lnsru/melexis_VGA_ToF_camera/impedance.png

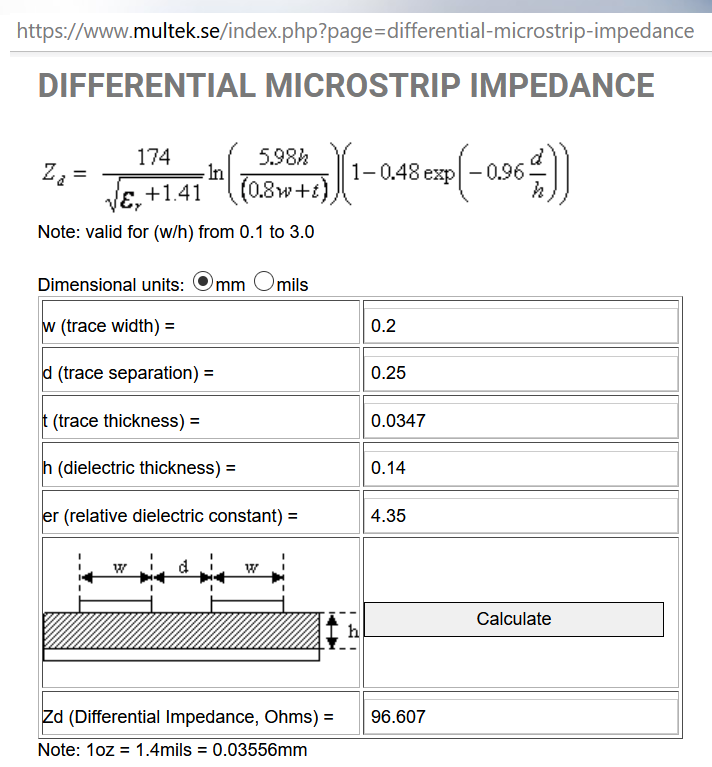
impedance.png
