lnsru/melexis_VGA_ToF_camera/BOM_v2/ToF_camera_VGA.xlsx

Reference | Quantity |  | Value | Footprint | Datasheet | Description | Height | Manufacturer_Name | Manufacturer_Part_Number | Mouser Part Number | Mouser Price/Stock
C10 | 1 |  | 430p | Capacitor_SMD:C_0805_2012Metric | ~
C22 C25 C20 C23 C26 C11 C12 C32 C33 | 9 |  | 100n | Capacitor_SMD:C_0805_2012Metric | ~
C5 C17 C15 C14 C1 C16 C3 C28 | 8 |  | 1u | Capacitor_SMD:C_0805_2012Metric | ~
C7 C6 C4 C2 | 4 | 50 | 4.7u | Capacitor_SMD:C_0805_2012Metric | ~
C9 C13 C18 C21 C19 C8 C31 C29 | 8 |  | 10u | Capacitor_SMD:C_0805_2012Metric | ~
CP27 | 1 |  | 68u | Capacitor_Tantalum_SMD:CP_EIA-7343-30_AVX-N | ~
D1 | 1 |  | LED | LED_SMD:LED_1206_3216Metric | ~
H1 H2 | 2 |  | MountingHole | myFootprints:MountingHole_1.5mm | ~
J1 | 1 | 6 | 54548-2271_connector_RPi_zero | myFootprints:545482271_RPi_Zero_connector | http://www.molex.com/webdocs/datasheets/pdf/en-us//0545482271_FFC_FPC_CONNECTORS.pdf | FFC & FPC Connectors 0.5 FPC ZIF Hsg Assy ssy 22Ckt EmbsTp Pkg | 1 | Molex | 54548-2271 | 538-54548-2271 | https://www.mouser.co.uk/ProductDetail/Molex/54548-2271?qs=qM7ngqbhX5X3ZiWzRWv9wA%3D%3D
J13 J11 J15 | 3 |  | Conn_01x01 | TestPoint:TestPoint_Pad_1.0x1.0mm | ~
J16 J10 J14 J12 | 4 |  | Conn_01x01 | TestPoint:TestPoint_Pad_2.0x2.0mm | ~
J17 J18 | 2 |  | Conn_01x01 | TestPoint:TestPoint_Pad_4.0x4.0mm | ~
J2 | 1 |  | Conn_01x01 | Connector_PinHeader_2.54mm:PinHeader_1x01_P2.54mm_Vertical | ~
J3 | 1 |  | Conn_01x04 | Connector_PinHeader_2.54mm:PinHeader_1x04_P2.54mm_Vertical | ~
J4 | 1 |  | Conn_01x01 | TestPoint:TestPoint_Pad_D1.5mm | ~
J5 J6 | 2 |  | Conn_01x04 | Connector_PinHeader_2.54mm:PinHeader_2x02_P2.54mm_Vertical | ~
J7 | 1 |  | Conn_01x02 | Resistor_SMD:R_0603_1608Metric | ~
J9 | 1 |  | Conn_01x03 | Jumper:SolderJumper-3_P1.3mm_Bridged2Bar12_RoundedPad1.0x1.5mm | ~
L1 | 1 |  | L | Inductor_SMD:L_1210_3225Metric | ~
MK1 MK2 MK3 MK4 | 4 |  | Mounting_Hole_PAD | MountingHole:MountingHole_3.2mm_M3
R17 | 1 | 50 | 10k | Resistor_SMD:R_0805_2012Metric | ~
R2 R1 | 2 |  | 1k5 | Resistor_SMD:R_0805_2012Metric | ~
R3 | 1 |  | 200k | Resistor_SMD:R_0805_2012Metric | ~
R6 | 1 |  | 100k | Resistor_SMD:R_0805_2012Metric | ~
R7 | 1 |  | 49.9k | Resistor_SMD:R_0805_2012Metric | ~
SW1 | 1 |  | SW_Push | Button_Switch_SMD:SW_SPST_EVPBF | ~
U1 | 1 |  | LP5907MFX-1.8 | Package_TO_SOT_SMD:SOT-23-5 | http://www.ti.com/lit/ds/symlink/lp5907.pdf
U2 | 1 |  | MLX75027 | myFootprints:MLX75027_NSMD
U3 | 1 |  | LP5907MFX-1.2 | Package_TO_SOT_SMD:SOT-23-5 | http://www.ti.com/lit/ds/symlink/lp5907.pdf
U4 | 1 |  | LP5907MFX-2.8 | Package_TO_SOT_SMD:SOT-23-5 | http://www.ti.com/lit/ds/symlink/lp5907.pdf
U5 | 1 | 5 | PCA9306 | Package_SO:SSOP-8_2.95x2.8mm_P0.65mm | http://www.ti.com/lit/ds/symlink/pca9306.pdf
U6 | 1 |  | TPS82130 | Package_LGA:Texas_SIL0008D_MicroSiP-8-1EP_2.8x3mm_P0.65mm_EP1.1x1.9mm_ThermalVias | http://www.ti.com/lit/ds/symlink/tps82130.pdf
Y1 | 1 |  | DSC6011JI1A-008.0000_clock_source | myFootprints:DSC6011JI1A0080000_clock_source | https://componentsearchengine.com/Datasheets/1/DSC6011JI1A-008.0000.pdf | Standard Clock Oscillators MEMS Oscillator Ultr a Low PWR LVCMOS - | 0.89 | Microchip | DSC6011JI1A-008.0000 | 579-011JI1A0080000 | https://www.mouser.co.uk/ProductDetail/Microchip-Technology/DSC6011JI1A-0080000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
 |  |  | Solder flux | CQ4LF (https://www.mouser.de/ProductDetail/Chip-Quik/CQ4LF?qs=1mbolxNpo8eyk0SwJVaLbQ%3D%3D)
 |  |  | Solder paste | TS391AX50 | http://www.chipquik.com/datasheets/TS391AX50.pdf
