lnsru/melexis_VGA_ToF_camera/ToF_camera_VGA.ods

Sheet: ToF_camera_VGA
Reference | Quantity | Value | Footprint | Datasheet
C10 C14 C3 | 3 | 430p, 1m | Capacitors_SMD:C_0805 | ~
C1 C8 C9 C11 C12 C13 C15 C17 C18 C19 | 10 | 22u | Capacitors_SMD:C_0805 | ~
C16 | 1 | 220u | Capacitors_SMD:CP_Elec_4x5.8 | https://eu.mouser.com/ProductDetail/Lelon/VZT221M0JTR-0506 | VZT221M0JTR-0506
C5 | 1 | 1u | Capacitors_SMD:C_0805 | ~
C7 C6 C4 C2 | 4 | 4.7u | Capacitors_SMD:C_0805 | ~
J1 | 1 | Conn_01x22 | myFootprints:FPC_22 | https://eu.mouser.com/ProductDetail/Molex/54548-2271 | 54548-2271
J3 J5 J6 | 3 | Conn_01x04 | Pin_Headers:Pin_Header_Straight_1x04_Pitch2.54mm | ~
J4 J2 | 2 | Conn_01x01 | Pin_Headers:Pin_Header_Straight_1x01_Pitch2.54mm | ~
J8 | 1 | Conn_01x02 | Resistors_SMD:R_0201_NoSilk | ~
JP1 | 1 | SolderJumper_3_Open | Pin_Headers:Pin_Header_Straight_1x03_Pitch1.00mm_SMD_Pin1Right | ~
L1 | 1 | L | Inductors:Inductor_1212 | ~
MK1 MK2 MK3 MK4 | 4 | Mounting_Hole_PAD | Mounting_Holes:MountingHole_2.7mm
R12 | 1 | 124k | Resistors_SMD:R_0805 | ~
R14 | 1 | 4.12k | Resistors_SMD:R_0805 | ~
R15 | 1 | 110k | Resistors_SMD:R_0805 | ~
R16 | 1 | 200k | Resistors_SMD:R_0805 | ~
R2 R1 R10 R11 R17 | 5 | 10k | Resistors_SMD:R_0805 | ~
R4 | 1 | 237k | Resistors_SMD:R_0805 | ~
R6 R9 R3 | 3 | 100k | Resistors_SMD:R_0805 | ~
R7 | 1 | 49.9k | Resistors_SMD:R_0805 | ~
R8 R13 R5 | 3 | 100k | Resistors_SMD:R_0402 | ~
SW1 | 1 | SW_Push | Buttons_Switches_SMD:SW_SPST_EVPBF | https://eu.mouser.com/ProductDetail/Panasonic/EVP-BFAC1A000 | EVP-BFAC1A000
U2 | 1 | MLX75027 | myFootprints:MLX75027 | https://eu.mouser.com/ProductDetail/Melexis/MLX75027RTC-ABA-200-TR | MLX75027RTC-ABA-200-TR
U3 U4 U1 | 3 | TPS82150 | myFootprints:TPS82130 | https://eu.mouser.com/ProductDetail/Texas-Instruments/TPS82150SILR |  | http://www.ti.com/lit/ds/symlink/tps82150.pdf
U5 | 1 | TPSM84624 | myFootprints:TPSM84624 | https://eu.mouser.com/ProductDetail/Texas-Instruments/TPSM84624MOLR
U6 | 1 | PCA9306 | Housings_SSOP:SSOP-8_2.95x2.8mm_Pitch0.65mm | https://eu.mouser.com/ProductDetail/Texas-Instruments/PCA9306DCTR | PCA9306DCTR | http://www.ti.com/lit/ds/symlink/pca9306.pdf
Y1 | 1 | Crystal | Crystals: 5 mm x 3.2 mm | https://eu.mouser.com/ProductDetail/ECS/ECS-80-12-30Q-DS-TR
 |  |  |  | https://eu.mouser.com/ProductDetail/TXC-Corporation/7A-8000MAAJ-T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

Sheet: ToF_camera_bw
Reference | Quantity | Value | Footprint | Datasheet
C10 C14 C3 | 3 | 430p, 1m | Capacitors_SMD:C_0805 | ~
C1 C8 C9 C11 C12 C13 C15 C17 C18 C19 | 10 | 22u | Capacitors_SMD:C_0805 | ~
C16 | 1 | 220u | Capacitors_SMD:CP_Elec_4x5.8 | https://eu.mouser.com/ProductDetail/Lelon/VZT221M0JTR-0506 | VZT221M0JTR-0506
C5 | 1 | 1u | Capacitors_SMD:C_0805 | ~
C7 C6 C4 C2 | 4 | 4.7u | Capacitors_SMD:C_0805 | ~
J1 | 1 | Conn_01x22 | myFootprints:FPC_22 | https://eu.mouser.com/ProductDetail/Molex/54548-2271 | 54548-2271
J3 J5 J6 | 3 | Conn_01x04 | Pin_Headers:Pin_Header_Straight_1x04_Pitch2.54mm | ~
J4 J2 | 2 | Conn_01x01 | Pin_Headers:Pin_Header_Straight_1x01_Pitch2.54mm | ~
J8 | 1 | Conn_01x02 | Resistors_SMD:R_0201_NoSilk | ~
JP1 | 1 | SolderJumper_3_Open | Pin_Headers:Pin_Header_Straight_1x03_Pitch1.00mm_SMD_Pin1Right | ~
L1 | 1 | L | Inductors:Inductor_1212 | ~
MK1 MK2 MK3 MK4 | 4 | Mounting_Hole_PAD | Mounting_Holes:MountingHole_2.7mm
R12 | 1 | 124k | Resistors_SMD:R_0805 | ~
R14 | 1 | 4.12k | Resistors_SMD:R_0805 | ~
R15 | 1 | 110k | Resistors_SMD:R_0805 | ~
R16 | 1 | 200k | Resistors_SMD:R_0805 | ~
R2 R1 R10 R11 R17 | 5 | 10k | Resistors_SMD:R_0805 | ~
R4 | 1 | 237k | Resistors_SMD:R_0805 | ~
R6 R9 R3 | 3 | 100k | Resistors_SMD:R_0805 | ~
R7 | 1 | 49.9k | Resistors_SMD:R_0805 | ~
R8 R13 R5 | 3 | 100k | Resistors_SMD:R_0402 | ~
SW1 | 1 | SW_Push | Buttons_Switches_SMD:SW_SPST_EVPBF | https://eu.mouser.com/ProductDetail/Panasonic/EVP-BFAC1A000 | EVP-BFAC1A000
U2 | 1 | MLX75027 | myFootprints:MLX75027 | https://eu.mouser.com/ProductDetail/Melexis/MLX75027RTC-ABA-200-TR | MLX75027RTC-ABA-200-TR
U3 U4 U1 | 3 | TPS82150 | myFootprints:TPS82130 | https://eu.mouser.com/ProductDetail/Texas-Instruments/TPS82150SILR |  | http://www.ti.com/lit/ds/symlink/tps82150.pdf
U5 | 1 | TPSM84624 | myFootprints:TPSM84624 | https://eu.mouser.com/ProductDetail/Texas-Instruments/TPSM84624MOLR
U6 | 1 | PCA9306 | Housings_SSOP:SSOP-8_2.95x2.8mm_Pitch0.65mm | https://eu.mouser.com/ProductDetail/Texas-Instruments/PCA9306DCTR | PCA9306DCTR | http://www.ti.com/lit/ds/symlink/pca9306.pdf
Y1 | 1 | Crystal | Crystals: 5 mm x 3.2 mm | https://eu.mouser.com/ProductDetail/ECS/ECS-80-12-30Q-DS-TR
 |  |  |  | https://eu.mouser.com/ProductDetail/TXC-Corporation/7A-8000MAAJ-T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
