lnsru/melexis_VGA_ToF_camera/Gerbers_v1/silkscreen.pdf

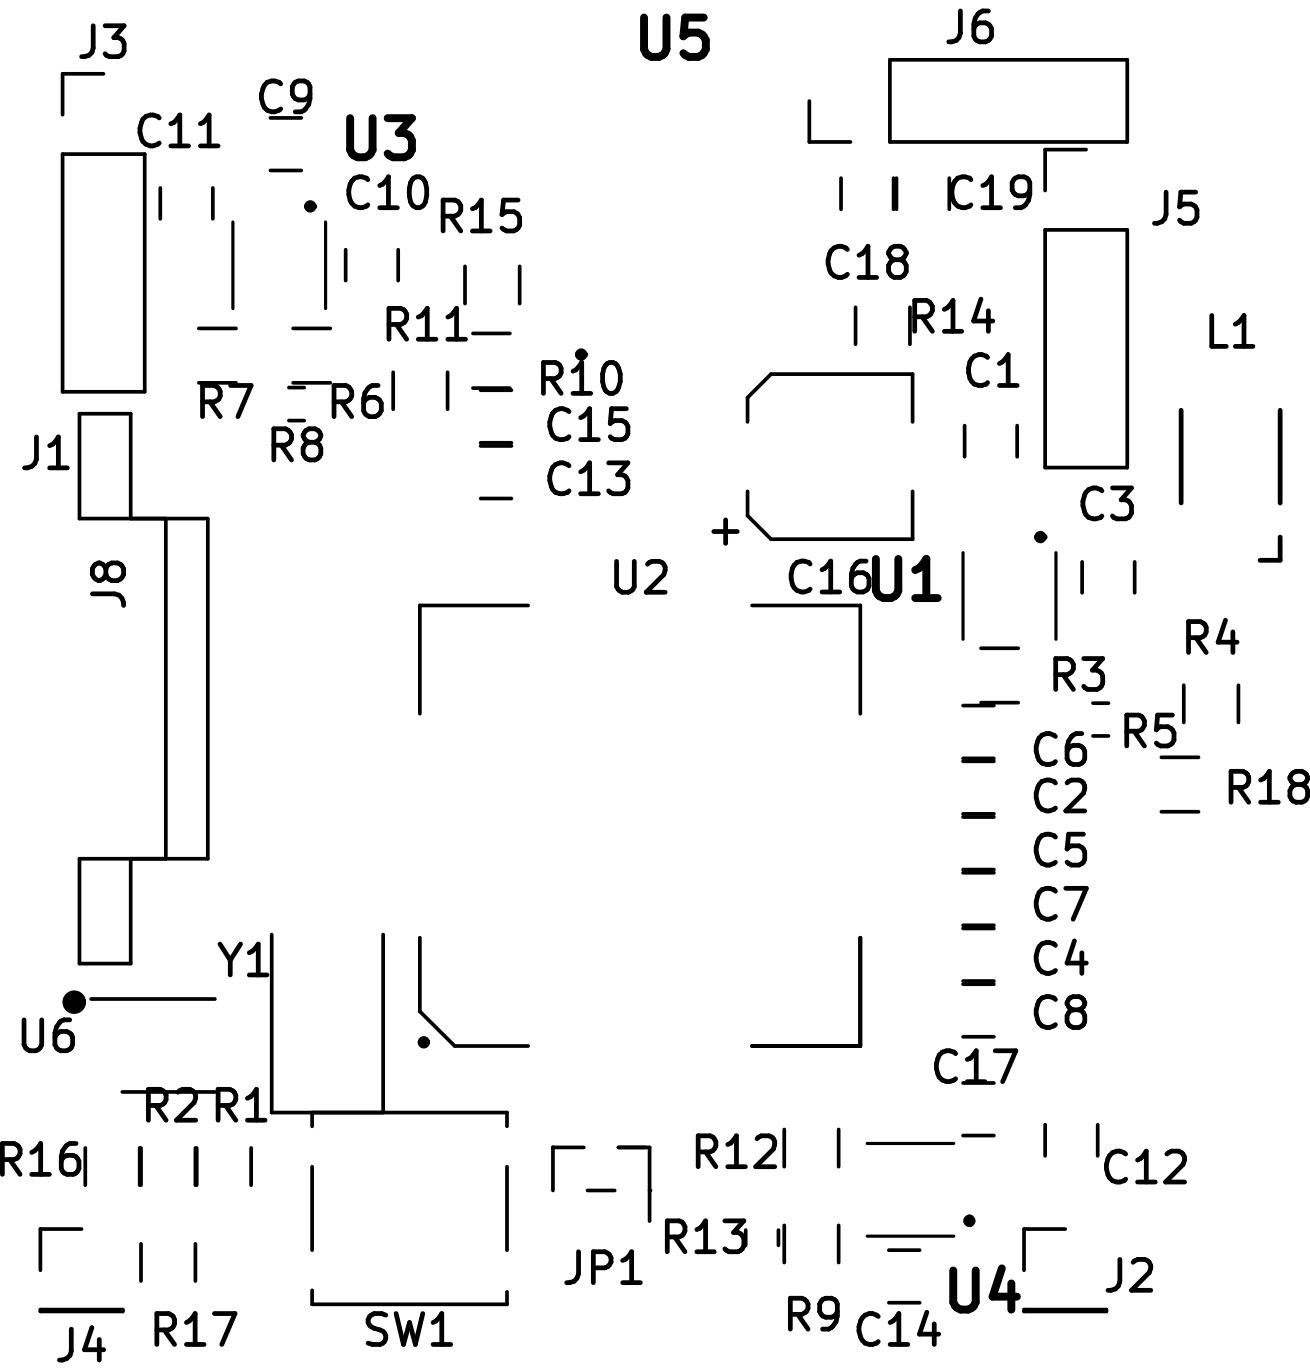
[picture p3: page 1]
