lnsru/melexis_VGA_ToF_camera/ToF_camera_VGA.kicad_pcb

## KiCad design ToF_camera_VGA.kicad_pcb (2021-11-09)

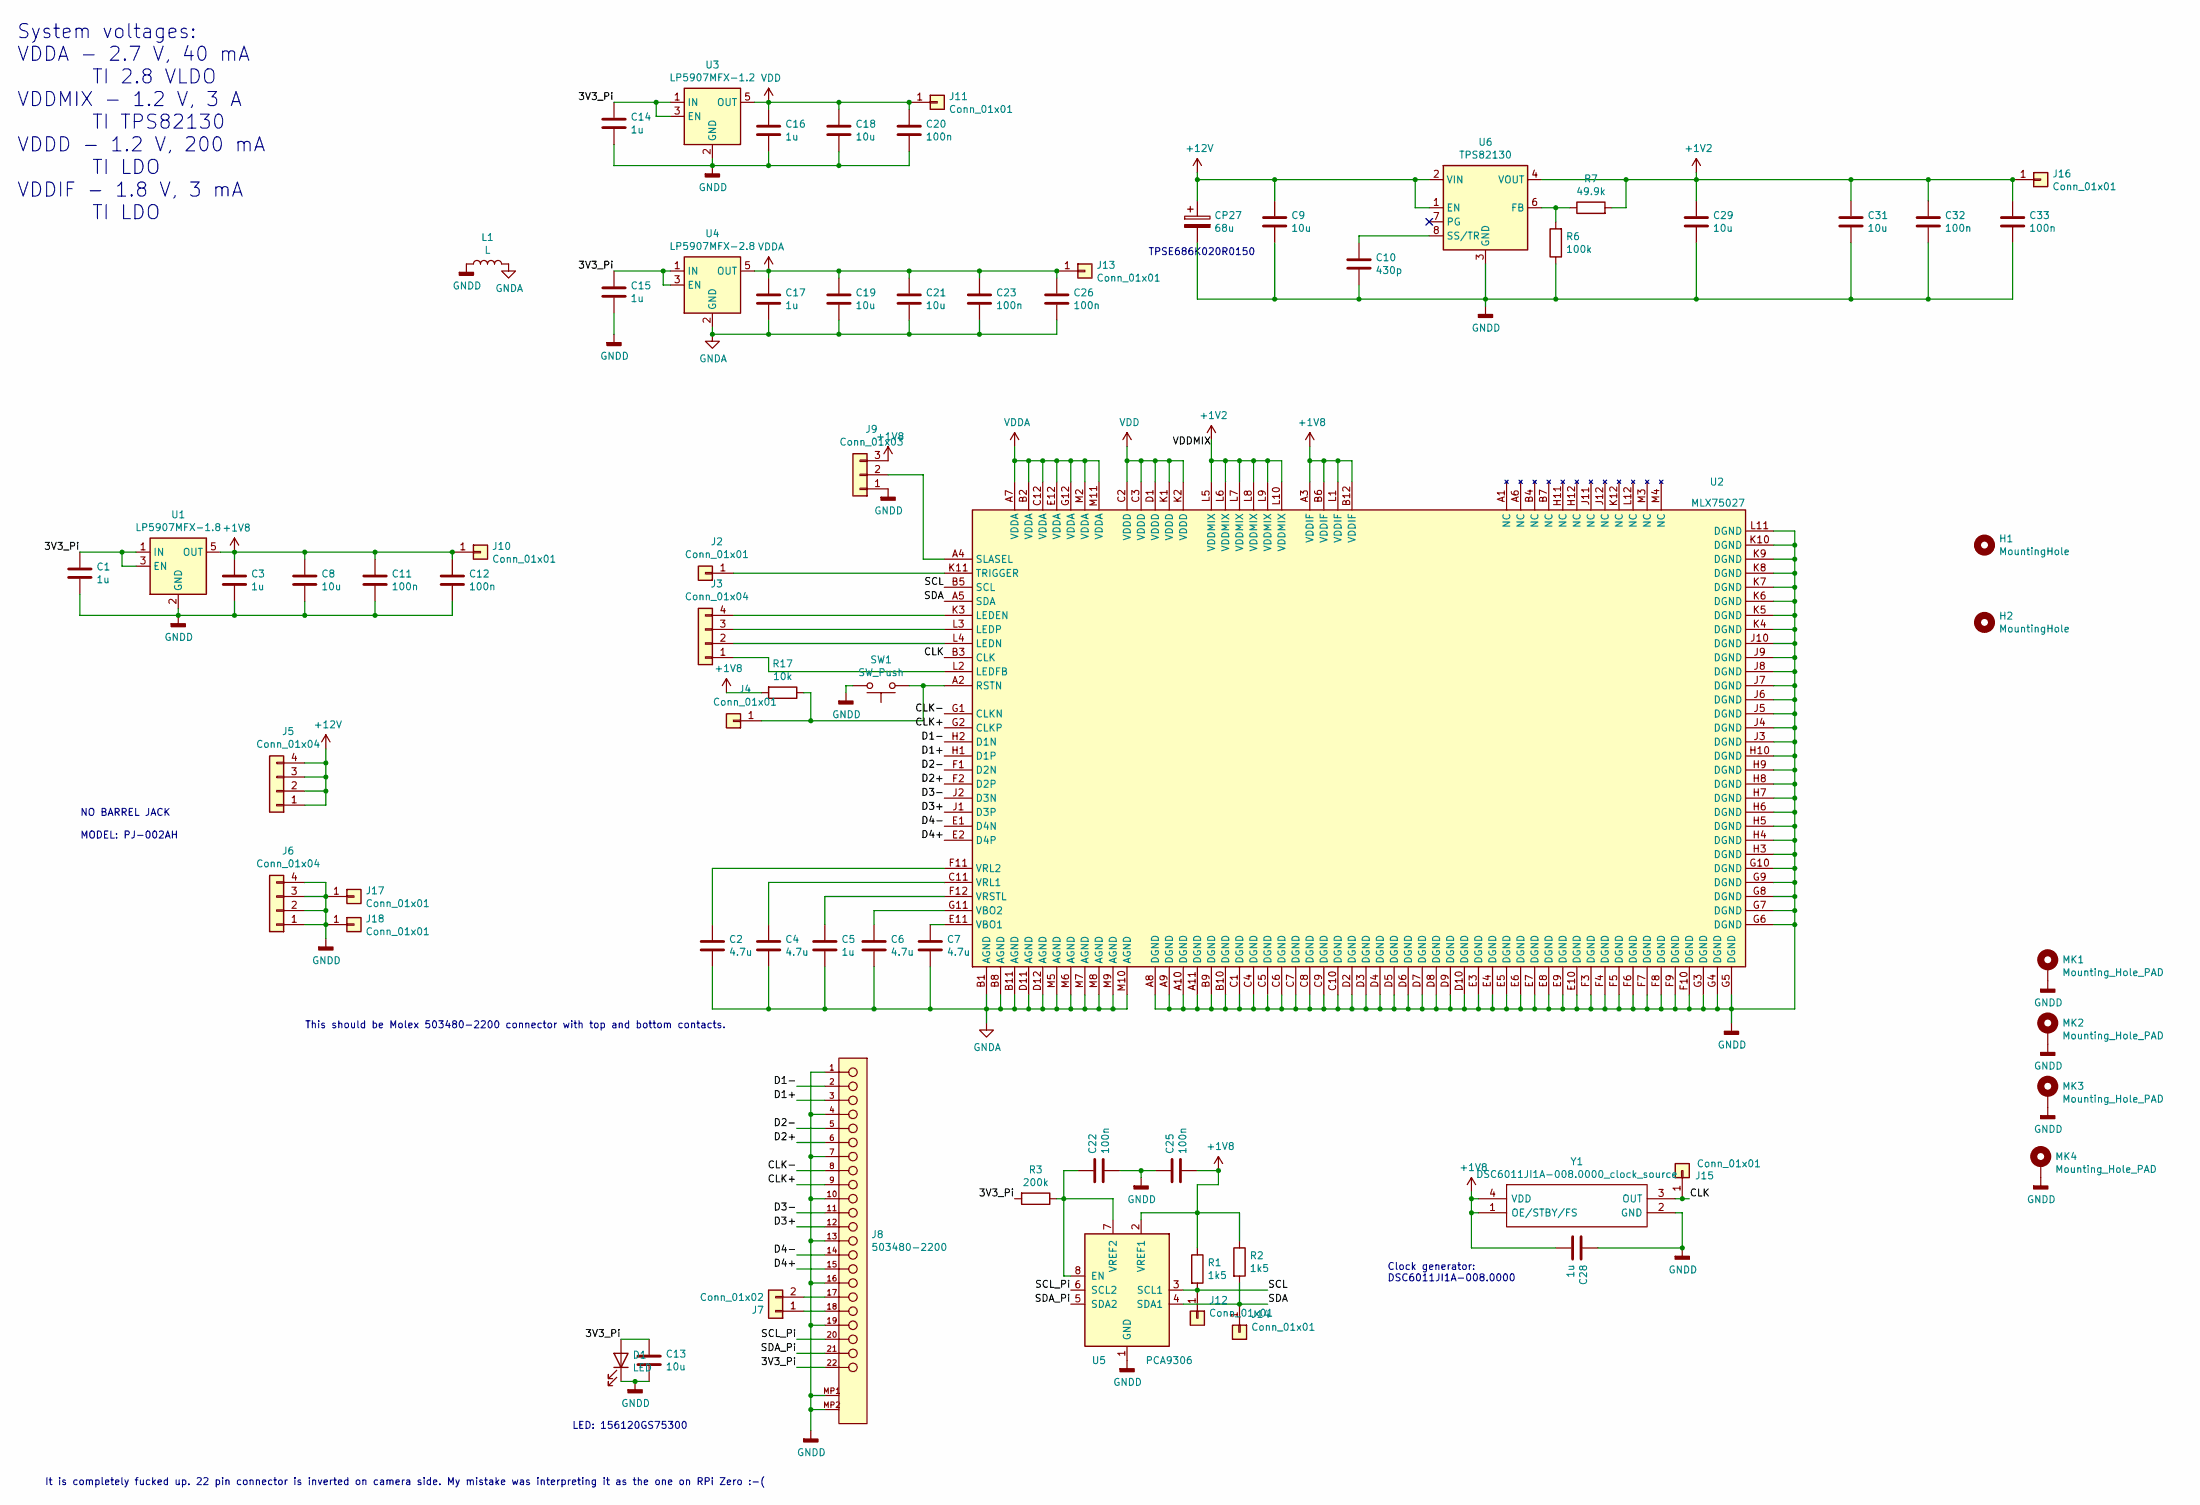
[picture p4: schematic ToF_camera_VGA.sch]

Parts:
C1, C3, C5, C14, C15, C16, C17, C28: 1u; C_0805_2012Metric
C2, C4, C6, C7: 4.7u; C_0805_2012Metric
C8, C9, C13, C18, C19, C21, C29, C31: 10u; C_0805_2012Metric
C10: 430p; C_0805_2012Metric
C11, C12, C20, C22, C23, C25, C26, C32, C33: 100n; C_0805_2012Metric
CP27: 68u; CP_EIA-7343-30_AVX-N
D1: LED; LED_1206_3216Metric
H1, H2: MountingHole; MountingHole_1.5mm
J2: Conn_01x01; PinHeader_1x01_P2.54mm_Vertical
J3: Conn_01x04; PinHeader_1x04_P2.54mm_Vertical
J4: Conn_01x01; TestPoint_Pad_D1.5mm
J5, J6: Conn_01x04; PinHeader_2x02_P2.54mm_Vertical
J7: Conn_01x02; R_0603_1608Metric
J8: 503480-2200; Molex-503480-2200; Voltage Max 50V AC (RMS)/DC
J9: Conn_01x03; SolderJumper-3_P1.3mm_Bridged2Bar12_RoundedPad1.0x1.5mm
J10, J12, J14, J16: Conn_01x01; TestPoint_Pad_2.0x2.0mm
J11, J13, J15: Conn_01x01; TestPoint_Pad_1.0x1.0mm
J17, J18: Conn_01x01; TestPoint_Pad_4.0x4.0mm
L1: L; L_1210_3225Metric
MK1, MK2, MK3, MK4: Mounting_Hole_PAD; MountingHole_3.2mm_M3
R1, R2: 1k5; R_0805_2012Metric
R3: 200k; R_0805_2012Metric
R6: 100k; R_0805_2012Metric
R7: 49.9k; R_0805_2012Metric
R17: 10k; R_0805_2012Metric
SW1: SW_Push; SW_SPST_EVPBF
U1: LP5907MFX-1.8; SOT-23-5
U2: MLX75027; MLX75027_NSMD
U3: LP5907MFX-1.2; SOT-23-5
U4: LP5907MFX-2.8; SOT-23-5
U5: PCA9306; SSOP-8_2.95x2.8mm_P0.65mm
U6: TPS82130; Texas_SIL0008D_MicroSiP-8-1EP_2.8x3mm_P0.65mm_EP1.1x1.9mm_T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
Y1: DSC6011JI1A-008.0000_clock_source; DSC6011JI1A0080000_clock_source; Mouser Part Number 579-011JI1A0080000

Connections:
+1V2: C29.1, C31.1, C32.1, C33.1, J16.1, R7.2, U2.L5 (VDDMIX), U2.L6 (VDDMIX), U2.L7 (VDDMIX), U2.L8 (VDDMIX), U2.L9 (VDDMIX), U2.L10 (VDDMIX), U6.4 (VOUT), U6.5 (VOUT)
+1V8: C3.1, C8.1, C11.1, C12.1, C25.2, C28.2, J9.3, J10.1, R1.1, R2.1, R17.2, U1.5 (OUT), U2.A3 (VDDIF), U2.B6 (VDDIF), U2.B12 (VDDIF), U2.L1 (VDDIF), U5.2 (VREF1), Y1.1 (OE/STBY/FS), Y1.4 (VDD)
+12V: C9.1, CP27.1, J5.1, J5.2, J5.3, J5.4, U6.1 (EN), U6.2 (VIN)
/3V3_Pi: C1.1, C13.1, C14.1, C15.1, D1.2 (A), J8.22, R3.2, U1.1 (IN), U1.3 (EN), U3.1 (IN), U3.3 (EN), U4.1 (IN), U4.3 (EN)
/CLK: J15.1, U2.B3 (CLK), Y1.3 (OUT)
/CLK+: J8.9, U2.G2 (CLKP)
/CLK-: J8.8, U2.G1 (CLKN)
/D1+: J8.3, U2.H1 (D1P)
/D1-: J8.2, U2.H2 (D1N)
/D2+: J8.6, U2.F2 (D2P)
/D2-: J8.5, U2.F1 (D2N)
/D3+: J8.12, U2.J1 (D3P)
/D3-: J8.11, U2.J2 (D3N)
/D4+: J8.15, U2.E2 (D4P)
/D4-: J8.14, U2.E1 (D4N)
/SCL: J12.1, R1.2, U2.B5 (SCL), U5.3 (SCL1)
/SCL_Pi: J8.20, U5.6 (SCL2)
/SDA: J14.1, R2.2, U2.A5 (SDA), U5.4 (SDA1)
/SDA_Pi: J8.21, U5.5 (SDA2)
GNDA: C2.2, C4.2, C5.2, C6.2, C7.2, C17.2, C19.2, C21.2, C23.2, C26.2, L1.2, U2.B1 (AGND), U2.B8 (AGND), U2.B11 (AGND), U2.D11 (AGND), U2.D12 (AGND), U2.M5 (AGND), U2.M6 (AGND), U2.M7 (AGND), U2.M8 (AGND), U2.M9 (AGND), U2.M10 (AGND), U4.2 (GND)
GNDD: C1.2, C3.2, C8.2, C9.2, C10.2, C11.2, C12.2, C13.2, C14.2, C15.2, C16.2, C18.2, C20.2, C22.2, C25.1, C28.1, C29.2, C31.2, C32.2, C33.2, CP27.2, D1.1 (K), J6.1, J6.2, J6.3, J6.4, J8.1, J8.4, J8.7, J8.10, J8.13, J8.16, J8.19, J8.MP1, J8.MP2, J9.1, J17.1, J18.1, L1.1, MK1.1, MK2.1, MK3.1, MK4.1, R6.1, SW1.2, U1.2 (GND), U2.A8 (DGND), U2.A9 (DGND), U2.A10 (DGND), U2.A11 (DGND), U2.B9 (DGND), U2.B10 (DGND), U2.C1 (DGND), U2.C4 (DGND), U2.C5 (DGND), U2.C6 (DGND), U2.C7 (DGND), U2.C8 (DGND), U2.C9 (DGND), U2.C10 (DGND), U2.D2 (DGND), U2.D3 (DGND), U2.D4 (DGND), U2.D5 (DGND), U2.D6 (DGND), U2.D7 (DGND), U2.D8 (DGND), U2.D9 (DGND), U2.D10 (DGND), U2.E3 (DGND), U2.E4 (DGND), U2.E5 (DGND), U2.E6 (DGND), U2.E7 (DGND), U2.E8 (DGND), U2.E9 (DGND), U2.E10 (DGND), U2.F3 (DGND), U2.F4 (DGND), U2.F5 (DGND), U2.F6 (DGND), U2.F7 (DGND), U2.F8 (DGND), U2.F9 (DGND), U2.F10 (DGND), U2.G3 (DGND), U2.G4 (DGND), U2.G5 (DGND), U2.G6 (DGND), U2.G7 (DGND), U2.G8 (DGND), U2.G9 (DGND), U2.G10 (DGND), U2.H3 (DGND), U2.H4 (DGND), U2.H5 (DGND), U2.H6 (DGND), U2.H7 (DGND), U2.H8 (DGND), U2.H9 (DGND), U2.H10 (DGND), U2.J3 (DGND), U2.J4 (DGND), U2.J5 (DGND), U2.J6 (DGND), U2.J7 (DGND), U2.J8 (DGND), U2.J9 (DGND), U2.J10 (DGND), U2.K4 (DGND), U2.K5 (DGND), U2.K6 (DGND), U2.K7 (DGND), U2.K8 (DGND), U2.K9 (DGND), U2.K10 (DGND), U2.L11 (DGND), U3.2 (GND), U5.1 (GND), U6.3 (GND), U6.9 (GND), Y1.2 (GND)
unnamed: C2.1, U2.F11 (VRL2)
unnamed: C4.1, U2.C11 (VRL1)
unnamed: C5.1, U2.F12 (VRSTL)
unnamed: C6.1, U2.G11 (VBO2)
unnamed: C7.1, U2.E11 (VBO1)
unnamed: C10.1, U6.8 (SS/TR)
unnamed: C22.1, R3.1, U5.7 (VREF2), U5.8 (EN)
unnamed: J2.1, U2.K11 (TRIGGER)
unnamed: J3.1, U2.L2 (LEDFB)
unnamed: J3.2, U2.L4 (LEDN)
unnamed: J3.3, U2.L3 (LEDP)
unnamed: J3.4, U2.K3 (LEDEN)
unnamed: J4.1, R17.1, SW1.1, U2.A2 (RSTN)
unnamed: J7.1, J8.18
unnamed: J7.2, J8.17
unnamed: J9.2, U2.A4 (SLASEL)
unnamed: R6.2, R7.1, U6.6 (FB)
VDD: C16.1, C18.1, C20.1, J11.1, U2.C2 (VDDD), U2.C3 (VDDD), U2.D1 (VDDD), U2.K1 (VDDD), U2.K2 (VDDD), U3.5 (OUT)
VDDA: C17.1, C19.1, C21.1, C23.1, C26.1, J13.1, U2.A7 (VDDA), U2.B2 (VDDA), U2.C12 (VDDA), U2.E12 (VDDA), U2.G12 (VDDA), U2.M2 (VDDA), U2.M11 (VDDA), U4.5 (OUT)

Notes on the sheet:
System voltages: VDDA - 2.7 V, 40 mA TI 2.8 VLDO VDDMIX - 1.2 V, 3 A TI TPS82130 VDDD - 1.2 V, 200 mA TI LDO VDDIF - 1.8 V, 3 mA TI LDO
LED: 156120GS75300
Clock generator: DSC6011JI1A-008.0000
TPSE686K020R0150
It is completely fucked up. 22 pin connector is inverted on camera side. My mistake was interpreting it as the one on RPi Zero :-(
NO BARREL JACK MODEL: PJ-002AH
This should be Molex 503480-2200 connector with top and bottom contacts.

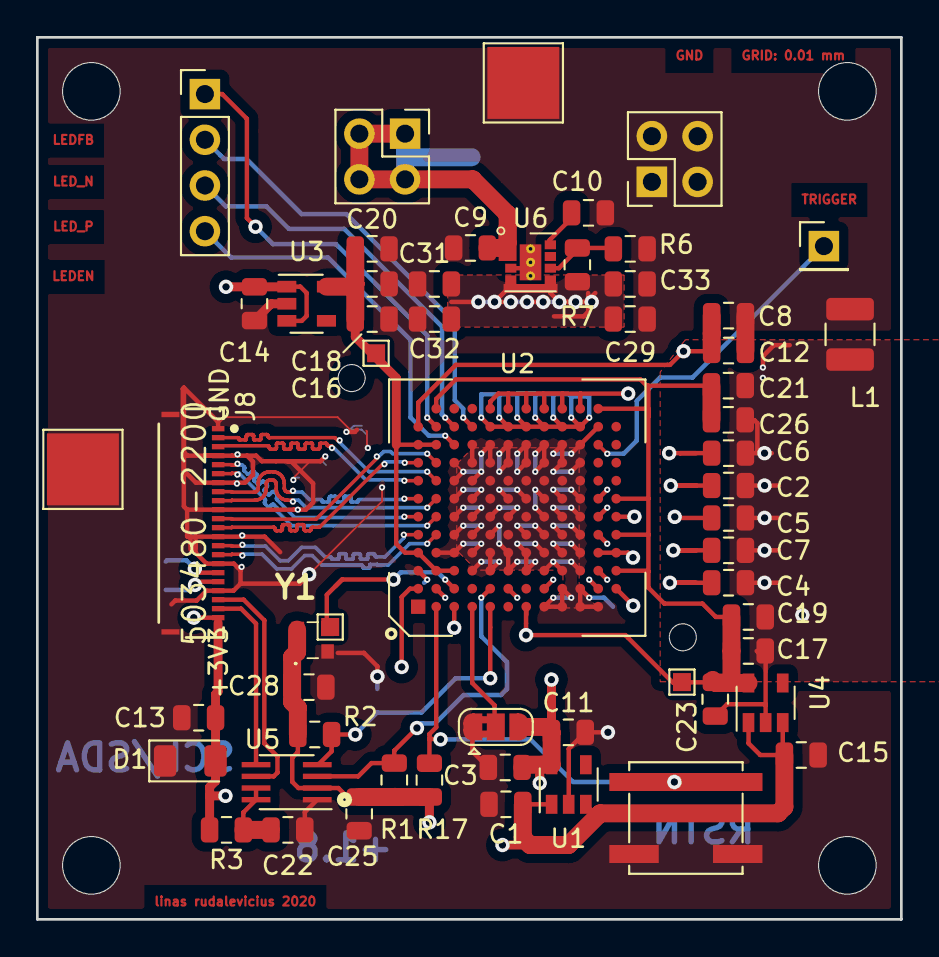
[picture p5: board ToF_camera_VGA.kicad_pcb from above]

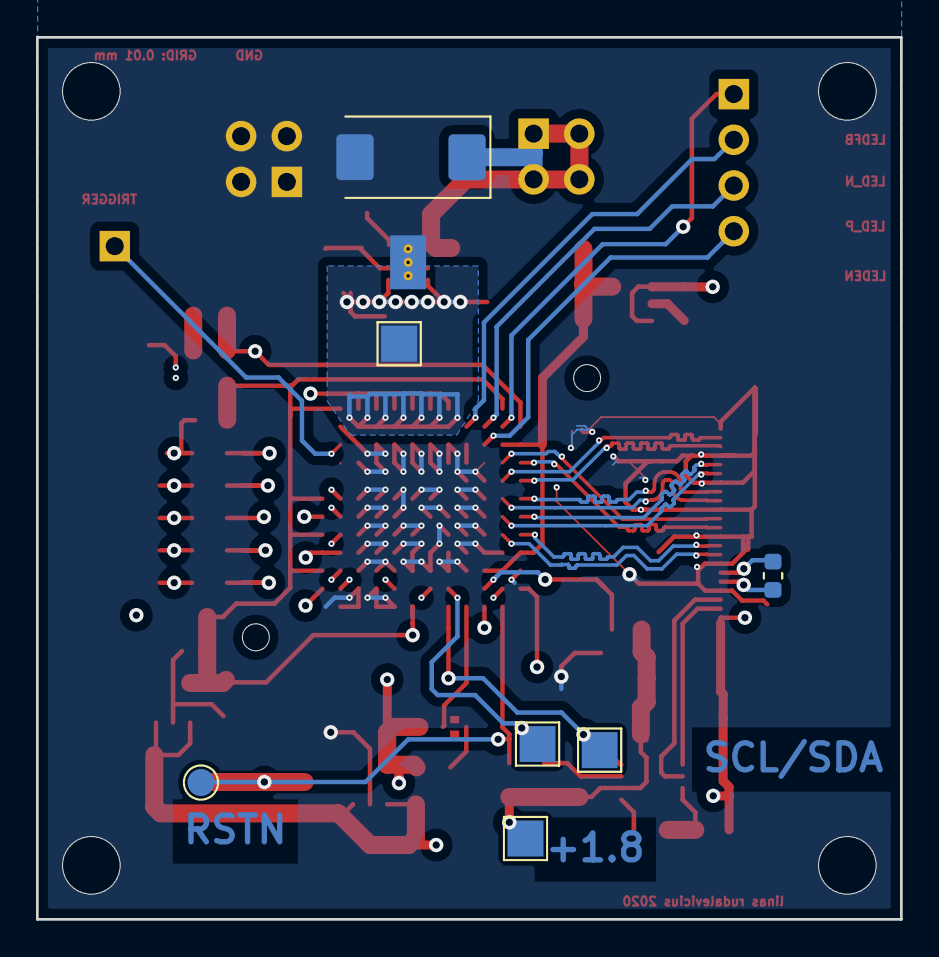
[picture p6: board ToF_camera_VGA.kicad_pcb from below]

Board: 4 copper layers, 48.0 x 49.0 mm, 70 parts (7 on the bottom side), 40 nets.
