lnsru/melexis_VGA_ToF_camera/(threads)

Thread 2 (2020-06-11):

Flat cable connector inverted

lnsru, 2020-06-11:

lnsru, 2020-08-16:
Raspberry Pi 22 pin connector isn't good for this, since Raspberry cable/adapter must be inverted contacts up.

-> Molex 5034802200 is a right part, but pcb must be adapted for it.

lnsru, 2021-11-09:
Schematic was accordingly updated

Closed 2021-11-09.

Thread 4 (2020-06-11):

I2c voltage shifter primary and secondary voltages swapped

lnsru, 2020-06-11:

lnsru, 2020-08-16:
I2C voltage level shifter placed good now and works well.

Closed 2020-08-16.

Thread 5 (2020-08-16):

Startup sequence

lnsru, 2020-08-16:
1. Reset pin must be routed to flat cable connector.
2. Probably clock enable pin should also be routed to flat cable connector.
3. Power up sequence as described in datasheet must be implemented.

Thread 6 (2020-10-21):

master control

LCKway, 2020-10-21:
What is your master control

lnsru, 2020-10-21:
???

LCKway, 2020-10-23:
I wouldn't use

The big guy taught me

lnsru, 2020-10-24:
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

What would you use?

LCKway, 2020-10-24:
raspberry
I can't use a “MLX_TOF_75027”
but i want to  make it "tof_camera"
Can you teach me?

lnsru, 2020-10-24:
I hope, you can buy it later from me :-)

LCKway, 2020-10-24:
Are you a commodity already?

LCKway, 2020-10-24:
Are you a commodity already?

lnsru, 2020-10-24:
I hope, next year. There are still some unfinished tasks

LCKway, 2020-10-24:
in other words
So you're not done yet?

lnsru, 2020-10-24:
Exactly! I am not done yet.

LCKway, 2020-10-24:
I'm just starting to make it now
I don't know if I can finish it before I graduate from college
I don't have any references to this stuff on my side

lnsru, 2020-10-24:
Layout works except inverted flat cable connector. Power supply might be also better, but that's already an optimization steps.

Closed 2020-10-21.

Thread 7 (2021-11-03):

Is the project finished?

tho1294, 2021-11-03:
Hello i find your project after long day of search about mlx75027 and i try to produce a same thing as you.
Is your project finished and working?

lnsru, 2021-11-03:
I can get test pattern from mlx75027, I am stuck with infrared illumination.

tho1294, 2021-11-03:
Oh good.
Do you have picture(photo) of your project?

lnsru, 2021-11-03:
Nothing fancy, this board with repaired connector attached to FPGA board or Raspberry Pi.
We could have an e-mail conversation, my mail is lnsru@protonmail.com
