lnsru/melexis_VGA_ToF_camera/(commit log)

2019-08-06 Inverted connector and re-routed CSI-2 lanes
    [ToF_camera_VGA.kicad_pcb, ToF_camera_VGA.sch]
2019-08-17 Almost there... minor modifications for production needed
    [ToF_camera_VGA.kicad_pcb, ToF_camera_VGA.sch]
2019-08-19 Added filter between analog and digital grounds. Moved to 5.1.4 KiCad version
    [ToF_camera_VGA.kicad_pcb, ToF_camera_VGA.sch]
2019-08-19 Fixed component markings on silkscreen
    [ToF_camera_VGA.kicad_pcb]
2019-08-21 Updated BOM
    [ToF_camera_VGA.kicad_pcb, ToF_camera_VGA.ods, ToF_camera_VGA.sch]
2019-08-25 Minor updates, production read. Added Gerbers
    [ToF_camera_VGA-B_Cu.gbl, ToF_camera_VGA-Cmts_User.gbr, ToF_camera_VGA-Dwgs_User.gbr, ToF_camera_VGA-Eco1_User.gbr, ToF_camera_VGA-Eco2_User.gbr, ToF_camera_VGA-Edge_Cuts.gm1, ToF_camera_VGA-F_Cu.gtl, ToF_camera_VGA-F_Mask.gts]
2020-08-08 Version 2 with fixed following issues: 1. clock source added 2. Flat cable connector should be ok 3. I2C level shifter should be ok 4. Power tree simplified, 12 V needed only for VDDMIX, others are g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
    [ToF_camera_VGA-B_Cu.gbl, ToF_camera_VGA-B_Mask.gbs, ToF_camera_VGA-Cmts_User.gbr, ToF_camera_VGA-Dwgs_User.gbr, ToF_camera_VGA-Eco1_User.gbr, ToF_camera_VGA-Eco2_User.gbr, ToF_camera_VGA-Edge_Cuts.gm1, ToF_camera_VGA-F_Cu.gtl]
2020-08-08 BOM added
    [ToF_camera_VGA.xlsx]
2021-11-09 Flat cable connector fixed. The right part is Molex 5034802200
    [ToF_camera_VGA.kicad_pcb, ToF_camera_VGA.sch]
2021-11-09 Picture added
    [ToF_camera_VGA.kicad_pcb]
